MohabElDean/Graduation-Project-in-Collaboration-with-Si-ware-on-a-Calibration-System-for-MEMS-Gas-Sensor/README.md

# 🔬 MEMS Gas Meter Calibration System

This repository documents the design and development of a **Calibration System for MEMS Gas Meters**, created as part of the Bachelor’s Degree in Mechatronics and Robotics Engineering at Egypt-Japan University of Science and Technology (E-JUST). The project was completed in collaboration with NeoSpectra Si-Ware.

## 📄 Project Description

The project focuses on improving the reliability and precision of **MEMS-based infrared (IR) gas sensors**, which are widely used for detecting various gases in environmental monitoring, industrial processes, and mobile robotics applications.

### Key Challenges Addressed

- **Thermal Management:** MEMS gas sensors are sensitive to heat fluctuations, which impact measurement accuracy. A thermal control system was developed using:
  - Thermoelectric coolers (TECs)
  - Heat pipes and heat sinks
  - Aluminum blocks as thermal interface materials (TIMs)
  - Thermal vias for enhanced heat transfer

- **Vibration Suppression:** Vibrations from drone or robot motion introduce noise and instability. Vibration damping solutions include:
  - PDMS and silicone rubber dampers
  - Specialized mechanical structures
  - Experimental testing for damping efficiency

- **Mechanical Design and Certification:** A robust sensor enclosure was designed:
  - Fiberglass mechanical housing
  - Gas chamber and cover designs
  - Components tested for overpressure, drop tests, and vibration resistance
  - Compliance with industry certifications (e.g., ATEX, IP67)

### Technological Highlights

- **Infrared Spectroscopy:** Used for gas detection by measuring specific IR absorption bands linked to gas molecular vibrations.
- **Thermal Circuit Simulation:** Thermal behavior modeled using LTspice simulations.
- **Material Selection:** Careful selection of materials such as PDMS, aluminum, and fiberglass for optimal mechanical and thermal properties.

## 🛠️ Methodology

The project involved three specialized teams:

- **Thermal Management Team**
  - Designed the cooling system using TECs
  - Simulated heat transfer and thermoelectric behavior
  - Engineered heat dissipation paths for stable sensor operation

- **Vibration Management Team**
  - Analyzed vibration sources in drones and mobile robots
  - Developed dampers using materials like PDMS
  - Built experimental setups for vibration analysis

- **Mechanical Design Team**
  - Engineered the mechanical structure for durability and gas tightness
  - Designed the gas chamber, sensor mounts, and structural elements
  - Performed structural analysis and physical testing

## ✅ Results & Conclusion

- The developed system significantly improves measurement precision and reliability for MEMS gas sensors under variable thermal and mechanical conditions.
- The design meets essential industry standards, enabling potential integration into mobile platforms such as drones or autonomous robots.
- Future work includes:
  - Optimizing thermal and vibration management for even lighter and more compact systems
  - Pursuing real-world field testing under diverse environmental conditions

---

**In Collaboration With:** NeoSpectra Si-Ware

The Project demo: 

https://github.com/user-attachments/assets/c7690575-35dc-4c8b-956d-5b22ecc9bf51
